jonnew/impedance/app/impedance-specification.markdown

Here i attempt to specify the functionality of the the impedance test/electrode plating application

Basic usage workflow

1. Enter global parameters
  * SPI port
2. Calibrate hardware
  1. Find the SPI cable delay. 
3. Calibrate the intan chip
4. Select a channel
  1. Select an impedance test frequency
  2. Select an impedance test amplitude
  3. Configute the impedance settings
  4. Measure impedancei
    1. Select series capacitance to generate current	
    2. Configure the impedance test settings
    3. Test impedance
    4. If not all capacitances have been checked, jump to (1) 
  5. Determine optimal impedance value
  6. Plate
    1. If at desired impedance then plate.
  7. Jump to (3)
