jonnew/impedance/impedance-pcb-intan/RHD2000_plating_board_assembly_guide.pptx

FR-4, 0.062” thick, gold immersion finish
Through-hole components and SMDs (no smaller than 0603) on top side only
(see BOM for details)

RHD2000 Plating Board

4.65”

0.125” holes in all four corners

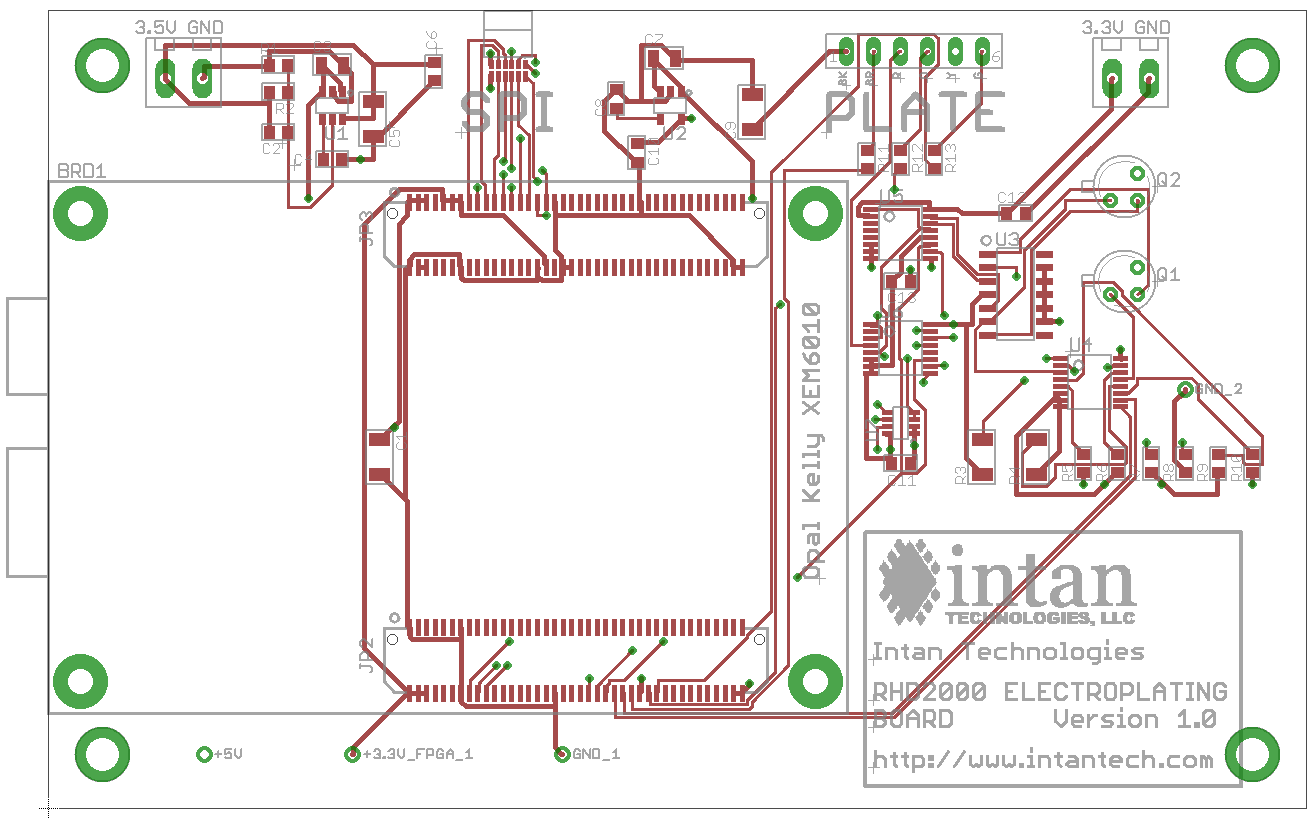
[picture p1: figure]

actual size

2.95”

## Slide 2

SMD Components (36 total)

Omnetics A79623

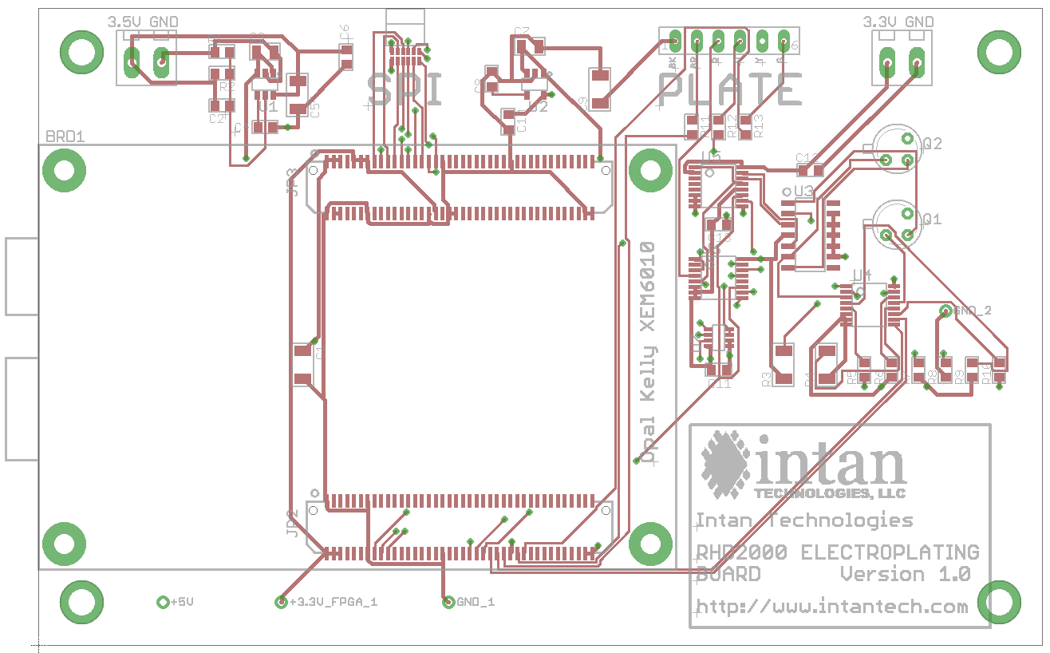
[picture p2: figure]

56.0 kΩ (1%)

30.1 kΩ (1%)

TPS79301

1 μF

22 μF

100 nF

10 nF

100 nF

1 μF

22 μF

15 pF

10 nF

Samtec BTE-040-01

TPS79333

100 Ω

100 nF

74HC4053

100 nF

OPA4170

22 μF

74HC4053

AD5662

74HC4052

100 nF

100 MΩ (1%)

100 MΩ (1%)

10.0 MΩ (1%)

10.0 MΩ (1%)

1.00 MΩ (1%)

1.00 MΩ (1%)

100 kΩ (1%)

100 kΩ (1%)

Samtec BTE-040-01

## Slide 3

Through-Hole Components (4 total)

Place terminal blocks with openings towards outside edge of board

ED1514

ED1514

2N3964

BC107
