jonnew/impedance/impedance-pcb/impedance_schematic.pdf

A

A

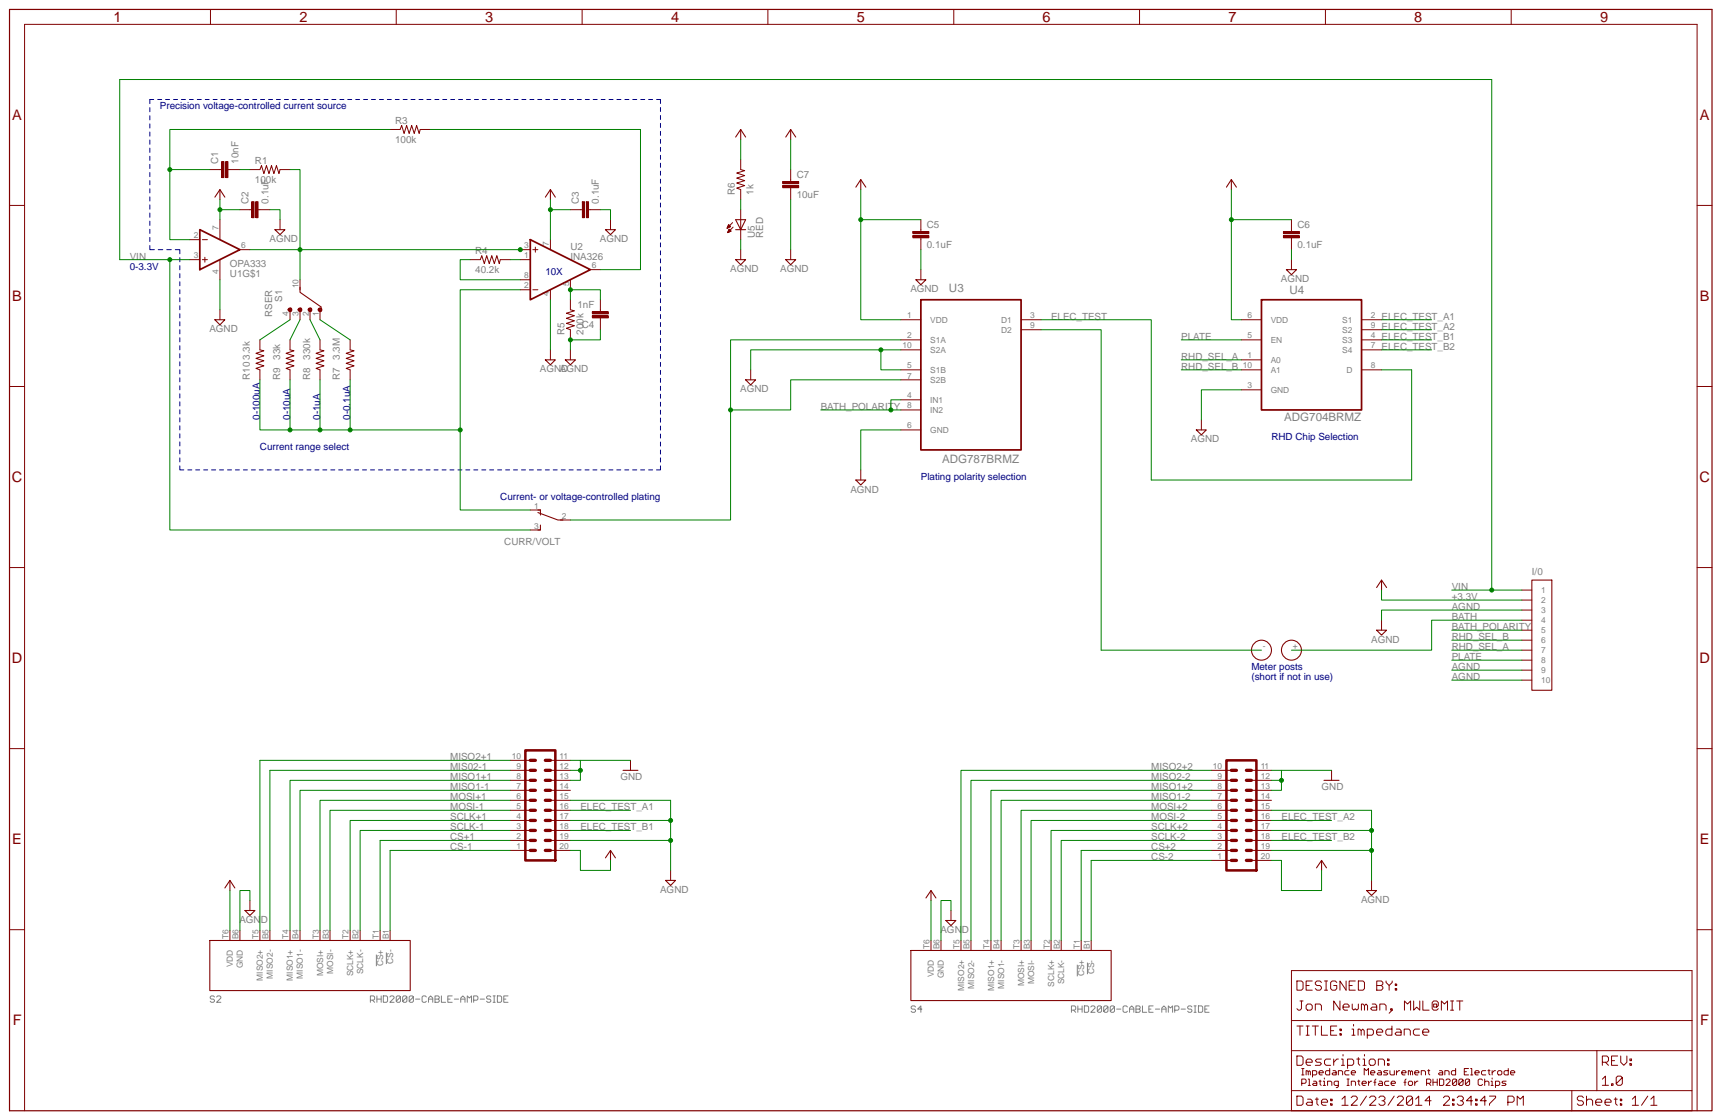
[picture p3: page 1]

Precision voltage-controlled current source

Current- or voltage-controlled plating

Meter posts
(short if not in use)
