jonnew/impedance/impedance-pcb-intan/RHD2000_plating_board.brd

## EAGLE design impedance-pcb-intan/RHD2000_plating_board.brd (2016-06-11)

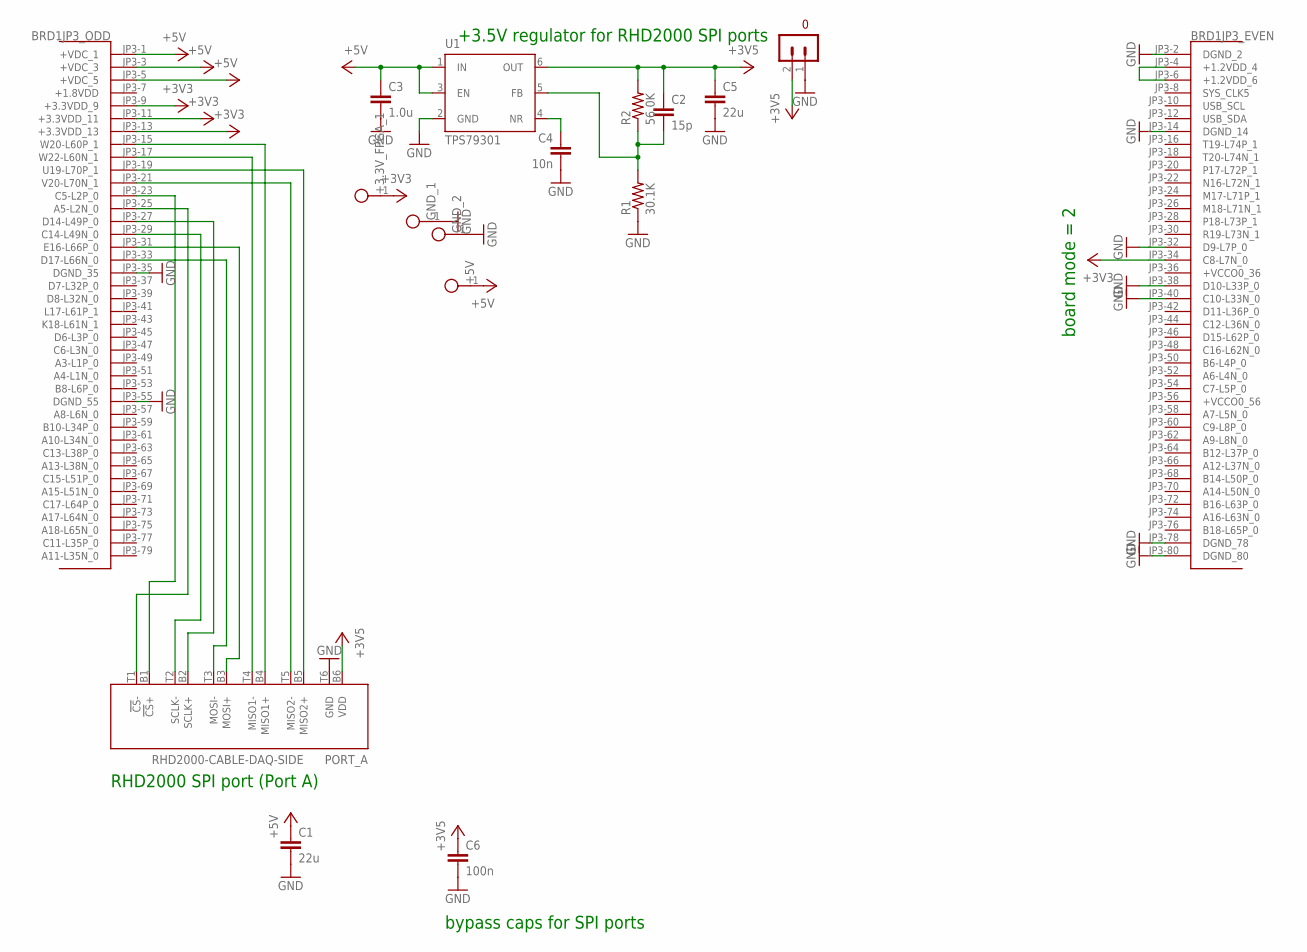
[picture p4: schematic RHD2000_plating_board.sch, sheet 1]

Parts:
+3.3V_FPGA_1, +5V: TESTPOINT
BRD1: OPALKELLY_XEM6010
C1, C5: 22u; 1206
C2: 15p; 0603
C3: 1.0u; 0805
C4: 10n; 0603
C6: 100n; 0603
GND_1, GND_2: TESTPOINT
PORT_A: RHD2000-CABLE-DAQ-SIDE; OMNETICS_PZN-12-AA
R1: 30.1K; 0603
R2: 56.0K; 0603
S2: TERMINAL_BLOCK_2-3.5MM-3.5V; TERMINAL_BLOCK_3.5MM_2_3.5V
U1: TPS79301; SOT-23-6

Connections:
+1.8VDD: BRD1.JP3-7 (+1.8VDD)
+3V3: +3.3V_FPGA_1.1, BRD1.JP3-9 (+3.3VDD_9), BRD1.JP3-11 (+3.3VDD_11), BRD1.JP3-13 (+3.3VDD_13), BRD1.JP3-34 (C8-L7N_0); also elsewhere on the board
+3V5: C2.1, C5.1, C6.1, PORT_A.B6 (VDD), R2.2, S2.2 (1), U1.6 (OUT)
+5V: +5V.1, BRD1.JP3-1 (+VDC_1), BRD1.JP3-3 (+VDC_3), BRD1.JP3-5 (+VDC_5), C1.1, C3.1, U1.1 (IN), U1.3 (EN); also elsewhere on the board
+VCCO0_36: BRD1.JP3-36 (+VCCO0_36)
+VCCO0_56: BRD1.JP3-56 (+VCCO0_56)
+VCCO1_35: BRD1.JP2-35 (+VCCO1_35)
+VCCO1_55: BRD1.JP2-55 (+VCCO1_55)
GND: BRD1.JP3-2 (DGND_2), BRD1.JP3-14 (DGND_14), BRD1.JP3-32 (D9-L7P_0), BRD1.JP3-35 (DGND_35), BRD1.JP3-38 (D10-L33P_0), BRD1.JP3-40 (C10-L33N_0), BRD1.JP3-55 (DGND_55), BRD1.JP3-78 (DGND_78), BRD1.JP3-80 (DGND_80), C1.2, C3.2, C4.2, C5.2, C6.2, GND_1.1, GND_2.1, PORT_A.T6 (GND), R1.1, S2.1 (0), U1.2 (GND); also elsewhere on the board
unnamed: BRD1.JP3-15 (W20-L60P_1), PORT_A.B4 (MISO1+)
unnamed: BRD1.JP3-17 (W22-L60N_1), PORT_A.T4 (MISO1-)
unnamed: BRD1.JP3-19 (U19-L70P_1), PORT_A.B5 (MISO2+)
unnamed: BRD1.JP3-21 (V20-L70N_1), PORT_A.T5 (MISO2-)
unnamed: BRD1.JP3-23 (C5-L2P_0), PORT_A.B1 (!CS!+)
unnamed: BRD1.JP3-25 (A5-L2N_0), PORT_A.T1 (!CS!-)
unnamed: BRD1.JP3-27 (D14-L49P_0), PORT_A.B2 (SCLK+)
unnamed: BRD1.JP3-29 (C14-L49N_0), PORT_A.T2 (SCLK-)
unnamed: BRD1.JP3-31 (E16-L66P_0), PORT_A.B3 (MOSI+)
unnamed: BRD1.JP3-33 (D17-L66N_0), PORT_A.T3 (MOSI-)
unnamed: C4.1, U1.4 (NR)
unnamed: C2.2, R1.2, R2.1, U1.5 (FB)
unnamed: BRD1.JP3-4 (+1.2VDD_4), BRD1.JP3-6 (+1.2VDD_6)

Notes on the sheet:
+3.5V regulator for RHD2000 SPI ports
RHD2000 SPI port (Port A)
board mode = 2
bypass caps for SPI ports

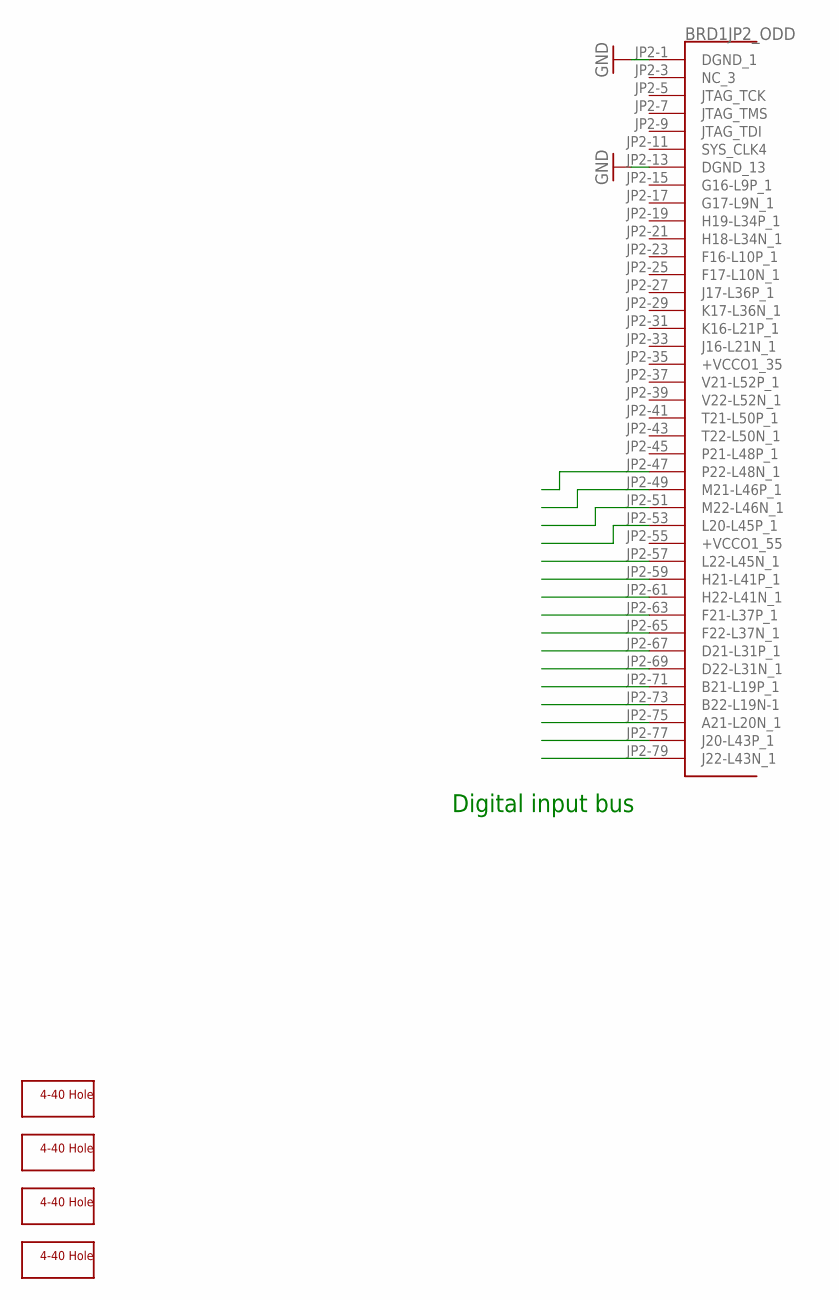
[picture p5: schematic RHD2000_plating_board.sch, sheet 2]

Parts:
BRD1: OPALKELLY_XEM6010
H1, H2, H3, H4: SCREW_HOLE_4-40

Connections:
+1.8VDD: BRD1.JP3-7 (+1.8VDD)
+VCCO0_36: BRD1.JP3-36 (+VCCO0_36)
+VCCO0_56: BRD1.JP3-56 (+VCCO0_56)
+VCCO1_35: BRD1.JP2-35 (+VCCO1_35)
+VCCO1_55: BRD1.JP2-55 (+VCCO1_55)
GND: BRD1.JP2-1 (DGND_1), BRD1.JP2-13 (DGND_13); also elsewhere on the board

Notes on the sheet:
Digital input bus

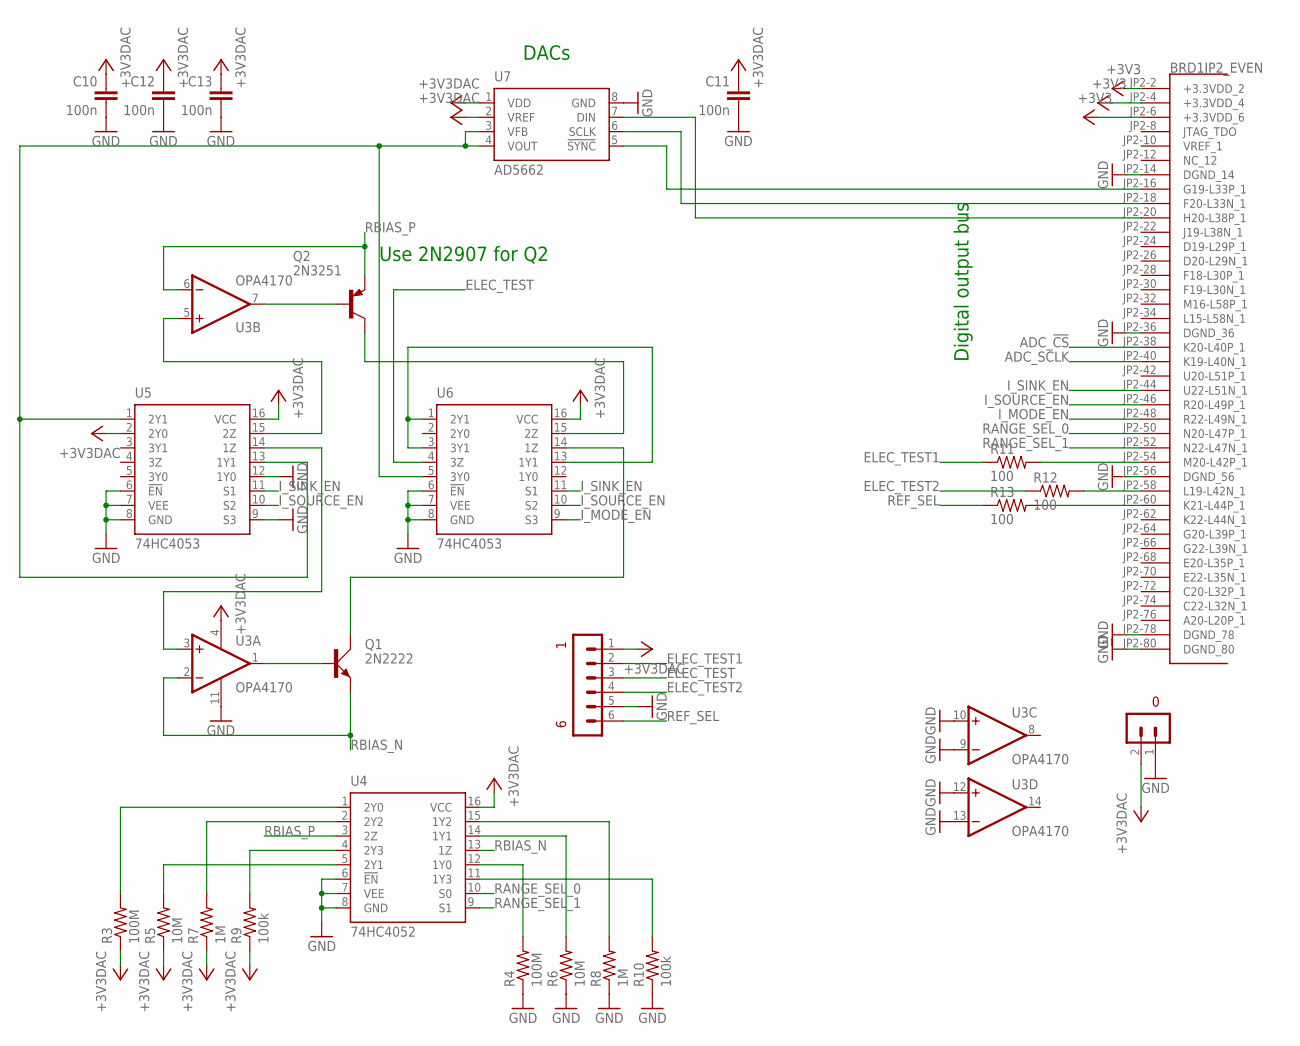
[picture p6: schematic RHD2000_plating_board.sch, sheet 3]

Parts:
BRD1: OPALKELLY_XEM6010
C10, C11, C12, C13: 100n; 0603
Q1: 2N2222; TO18A
Q2: 2N3251; TO18
R3, R4: 100M; 1206
R5, R6: 10M; 0603
R7, R8: 1M; 0603
R9, R10: 100k; 0603
R11, R12, R13: 100; 0603
S1: TERMINAL_BLOCK_2-3.5MM-3.3V; TERMINAL_BLOCK_3.5MM_2_3.3V
S3: WIRES-6
U3: OPA4170; SOIC-14
U4: 74HC4052; TSSOP-16
U5, U6: 74HC4053; TSSOP-16
U7: AD5662; SOT-23-RJ-8

Connections:
+1.8VDD: BRD1.JP3-7 (+1.8VDD)
+3V3: BRD1.JP2-2 (+3.3VDD_2), BRD1.JP2-4 (+3.3VDD_4), BRD1.JP2-6 (+3.3VDD_6); also elsewhere on the board
+3V3DAC: C10.1, C11.1, C12.1, C13.1, R3.1, R5.1, R7.1, R9.1, S1.2 (1), S3.1, U3.4 (V+), U4.16 (VCC), U5.2 (2Y0), U5.16 (VCC), U6.16 (VCC), U7.1 (VDD), U7.2 (VREF); also elsewhere on the board
+VCCO0_36: BRD1.JP3-36 (+VCCO0_36)
+VCCO0_56: BRD1.JP3-56 (+VCCO0_56)
+VCCO1_35: BRD1.JP2-35 (+VCCO1_35)
+VCCO1_55: BRD1.JP2-55 (+VCCO1_55)
ADC_!CS!: BRD1.JP2-38 (K20-L40P_1)
ADC_SCLK: BRD1.JP2-40 (K19-L40N_1)
ELEC_TEST: S3.3, U6.4 (3Z)
ELEC_TEST1: R11.1, S3.2
ELEC_TEST2: R12.1, S3.4
GND: BRD1.JP2-14 (DGND_14), BRD1.JP2-36 (DGND_36), BRD1.JP2-56 (DGND_56), BRD1.JP2-78 (DGND_78), BRD1.JP2-80 (DGND_80), C10.2, C11.2, C12.2, C13.2, R4.1, R6.1, R8.1, R10.1, S1.1 (0), S3.5, U3.9 (-IN), U3.10 (+IN), U3.11 (V-), U3.12 (+IN), U3.13 (-IN), U4.6 (!EN!), U4.7 (VEE), U4.8 (GND), U5.6 (!EN!), U5.7 (VEE), U5.8 (GND), U5.9 (S3), U5.12 (1Y0), U6.6 (!EN!), U6.7 (VEE), U6.8 (GND), U7.8 (GND); also elsewhere on the board
I_MODE_EN: BRD1.JP2-48 (R22-L49N_1), U6.9 (S3)
I_SINK_EN: BRD1.JP2-44 (U22-L51N_1), U5.11 (S1), U6.11 (S1)
I_SOURCE_EN: BRD1.JP2-46 (R20-L49P_1), U5.10 (S2), U6.10 (S2)
unnamed: Q1.B, U3.1 (OUT)
unnamed: U5.1 (2Y1), U5.13 (1Y1), U6.5 (3Y0), U7.3 (VFB), U7.4 (VOUT)
unnamed: U3.3 (+IN), U5.14 (1Z)
unnamed: Q1.C, U6.14 (1Z)
unnamed: U3.5 (+IN), U5.15 (2Z)
unnamed: Q2.2 (B), U3.7 (OUT)
unnamed: Q2.3 (C), U6.15 (2Z)
unnamed: BRD1.JP2-54 (M20-L42P_1), R11.2
unnamed: BRD1.JP2-58 (L19-L42N_1), R12.2
unnamed: R9.2, U4.4 (2Y3)
unnamed: R7.2, U4.2 (2Y2)
unnamed: R5.2, U4.5 (2Y1)
unnamed: R3.2, U4.1 (2Y0)
unnamed: R4.2, U4.12 (1Y0)
unnamed: R6.2, U4.14 (1Y1)
unnamed: R8.2, U4.15 (1Y2)
unnamed: R10.2, U4.11 (1Y3)
unnamed: U6.1 (2Y1), U6.3 (3Y1), U6.13 (1Y1)
unnamed: BRD1.JP2-60 (K21-L44P_1), R13.2
unnamed: BRD1.JP2-16 (G19-L33P_1), U7.5 (!SYNC!)
unnamed: BRD1.JP2-18 (F20-L33N_1), U7.6 (SCLK)
unnamed: BRD1.JP2-20 (H20-L38P_1), U7.7 (DIN)
RANGE_SEL_0: BRD1.JP2-50 (N20-L47P_1), U4.10 (S0)
RANGE_SEL_1: BRD1.JP2-52 (N22-L47N_1), U4.9 (S1)
RBIAS_N: Q1.E, U3.2 (-IN), U4.13 (1Z)
RBIAS_P: Q2.1 (E), U3.6 (-IN), U4.3 (2Z)
REF_SEL: R13.1, S3.6

Notes on the sheet:
DACs
Digital output bus
Use 2N2907 for Q2

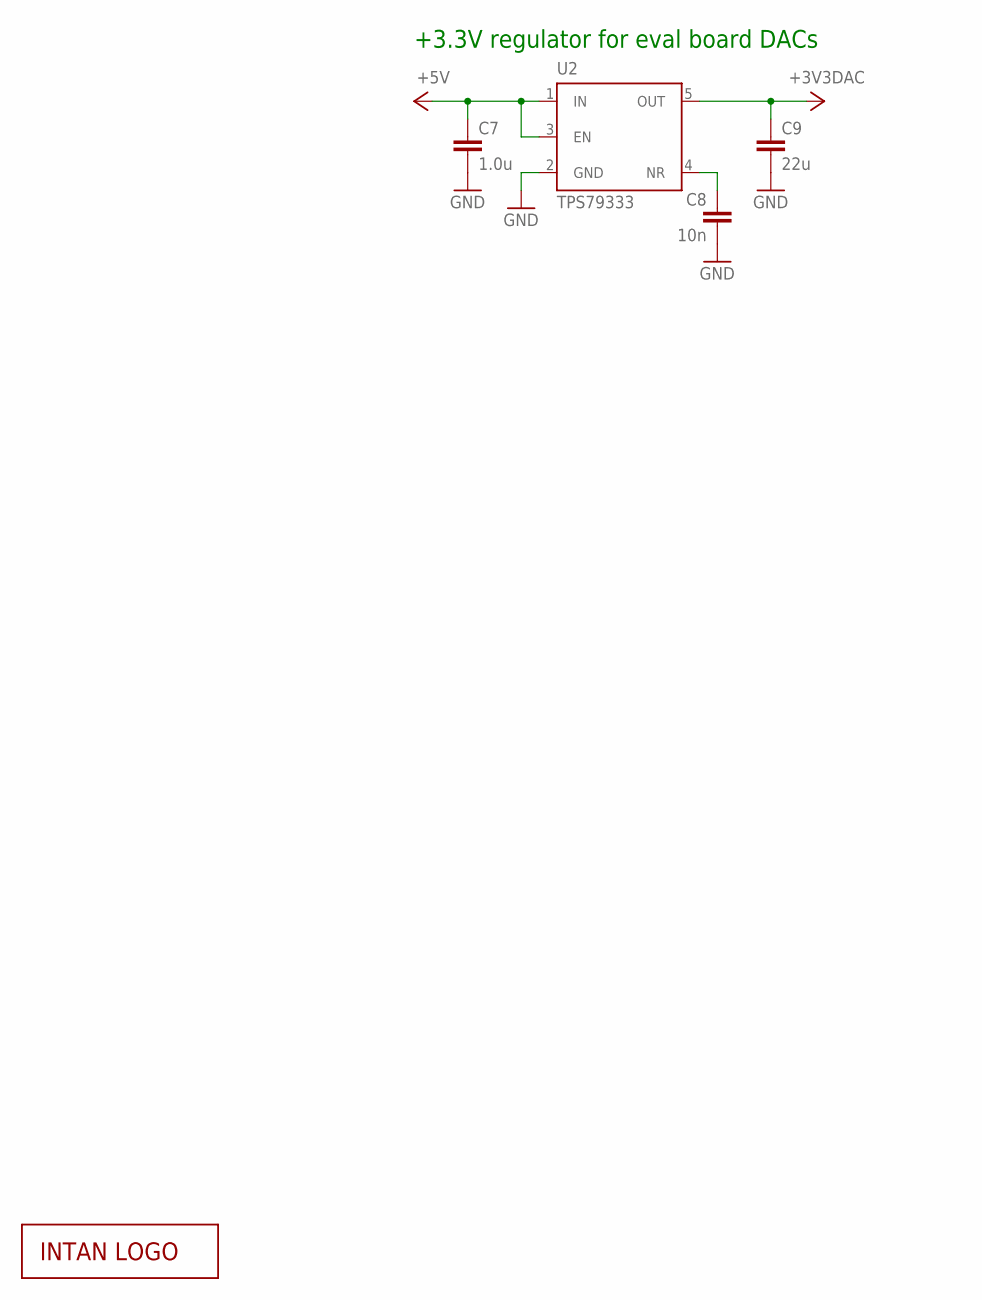
[picture p7: schematic RHD2000_plating_board.sch, sheet 4]

Parts:
C7: 1.0u; 0805
C8: 10n; 0603
C9: 22u; 1206
LOGO1: INTAN_LOGO
U2: TPS79333; SOT-23-5

Connections:
+3V3DAC: C9.1, U2.5 (OUT); also elsewhere on the board
+5V: C7.1, U2.1 (IN), U2.3 (EN); also elsewhere on the board
GND: C7.2, C8.2, C9.2, U2.2 (GND); also elsewhere on the board
unnamed: C8.1, U2.4 (NR)

Notes on the sheet:
+3.3V regulator for eval board DACs

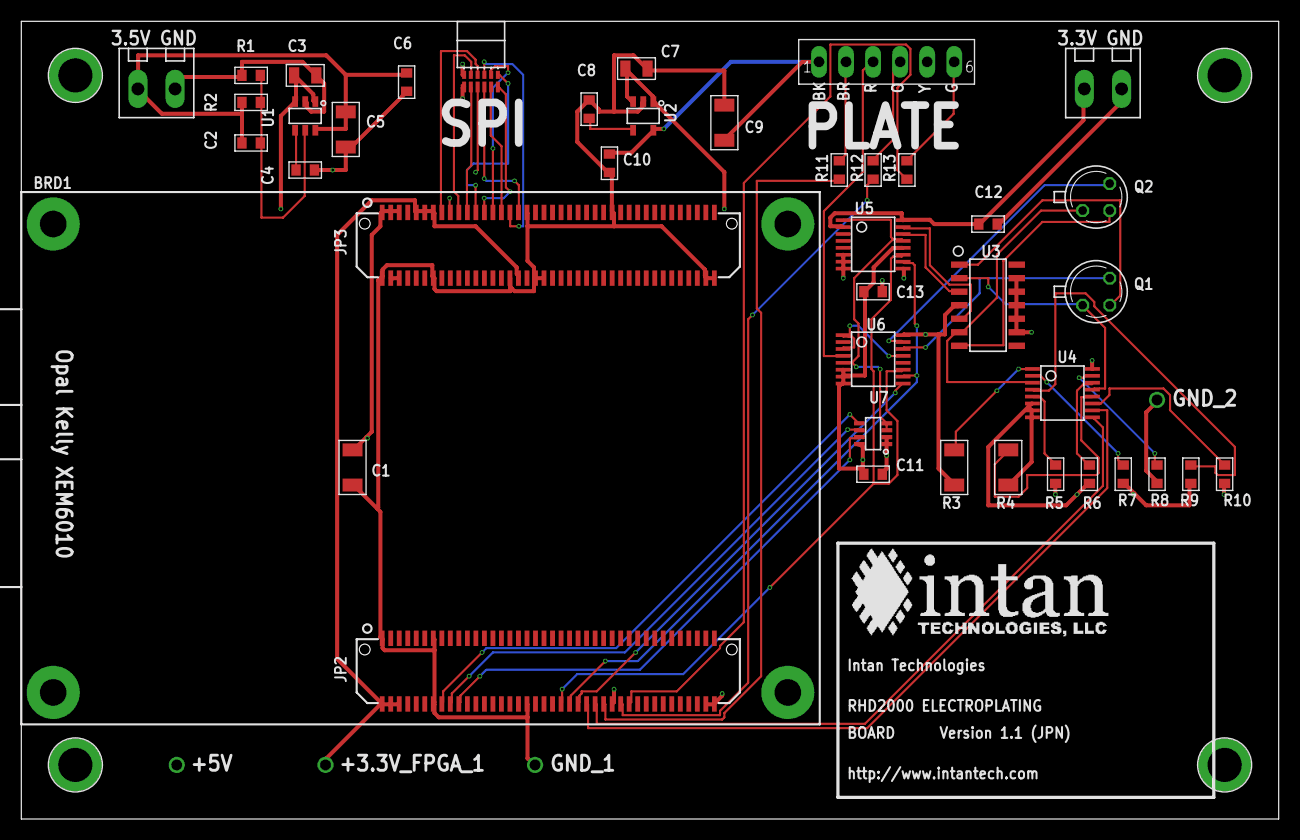
[picture p8: board RHD2000_plating_board.brd from above]

Board: 4 copper layers, 118.1 x 74.9 mm, 49 parts (0 on the bottom side), 52 nets.
