jonnew/impedance/impedance-pcb/impedance.brd

## EAGLE design impedance-pcb/impedance.brd (2014-12-23)

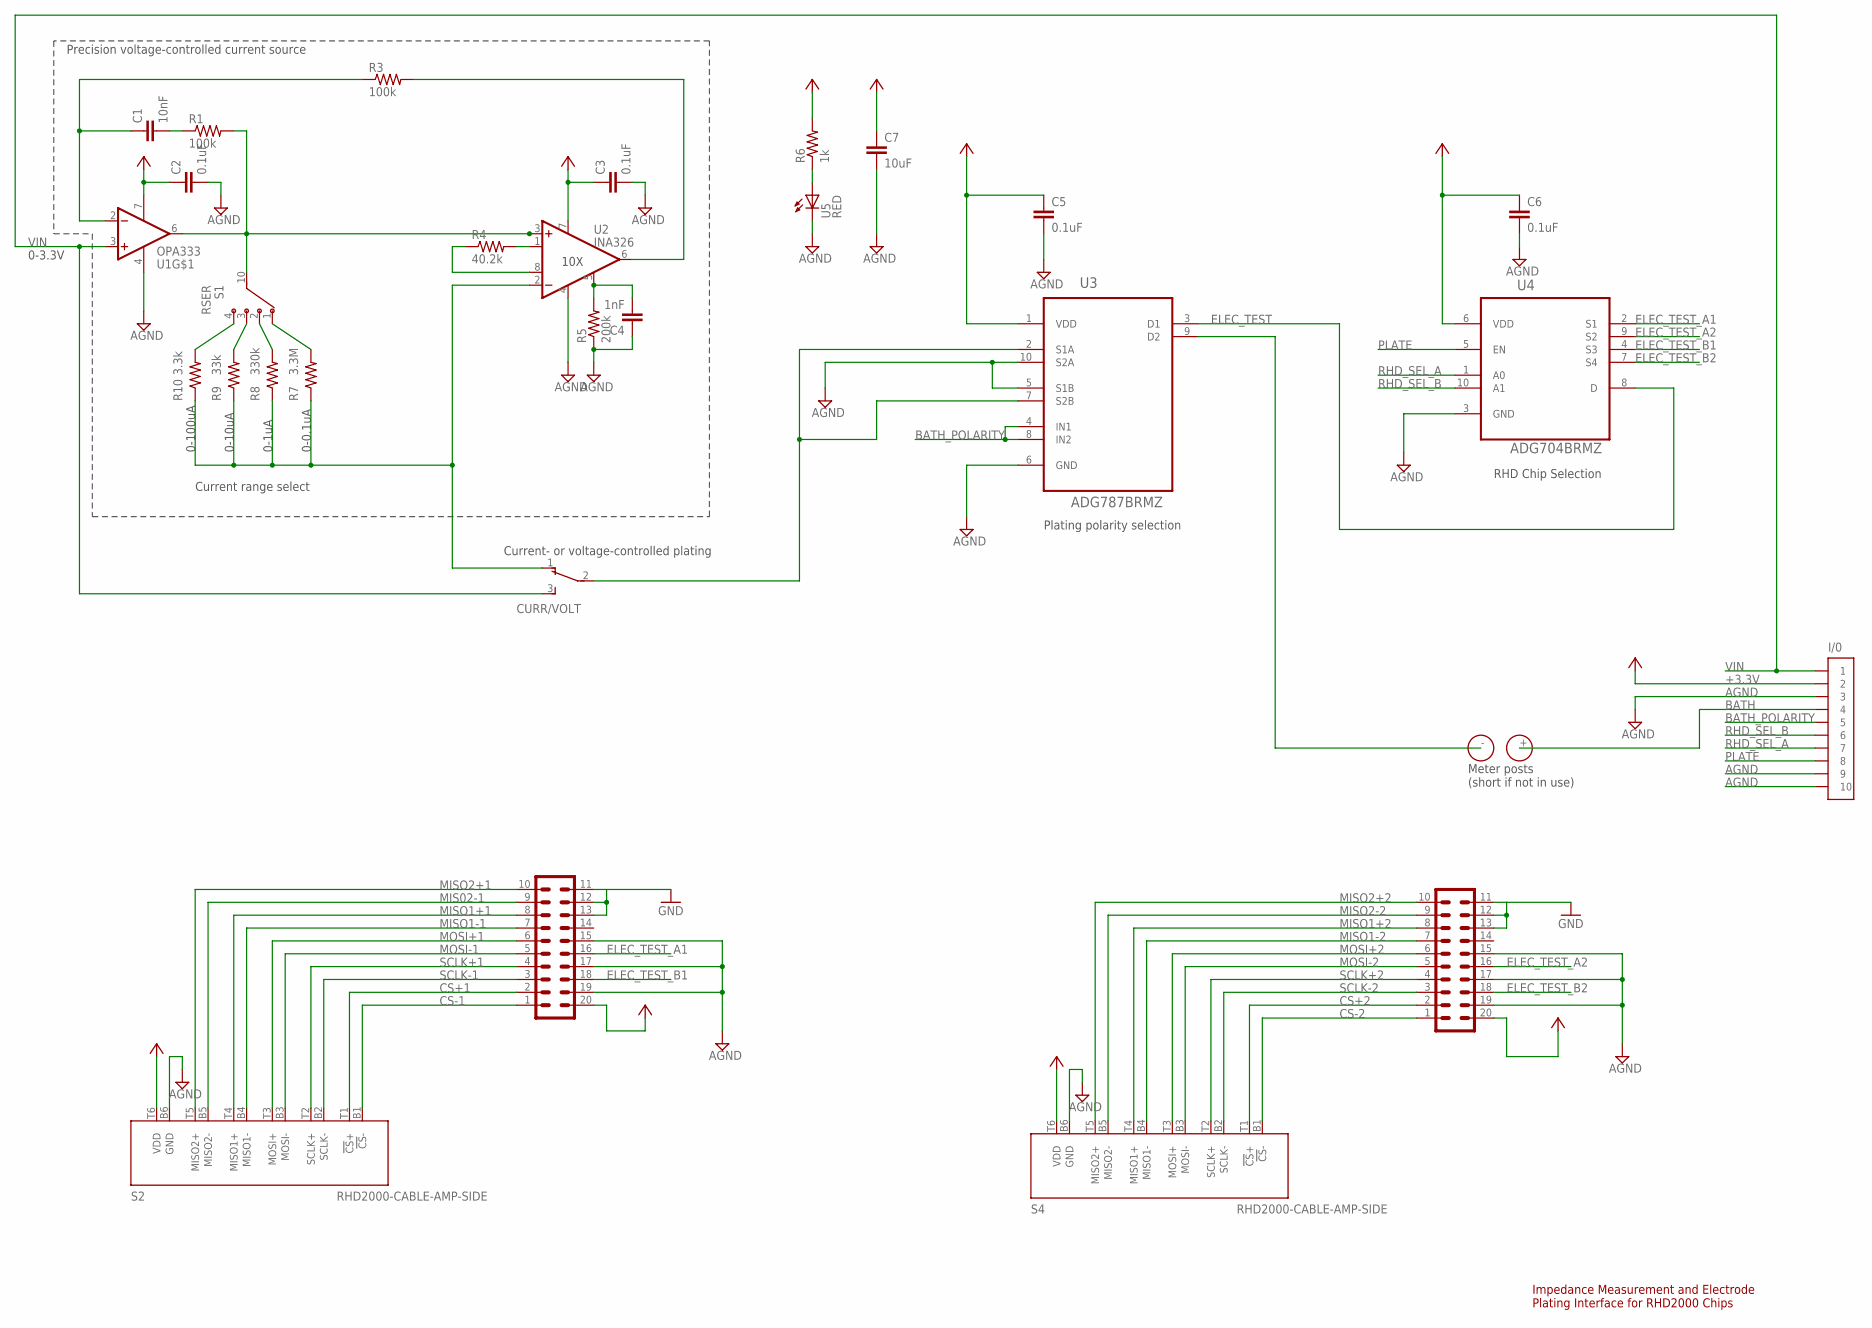
[picture p9: schematic impedance.sch]

Parts:
C1: 10nF; 0805
C2, C3, C5, C6: 0.1uF; 0805
C4: 1nF; 0805
C7: 10uF; 1206
CURR/VOLT: SPDT_PCM12; PCM12
HS1, HS2: JMD20-V
I/0: SCREW10_0.1-THRU; SCREW10
R1, R3: 100k; 0805
R4: 40.2k; 0805
R5: 200k; 0805
R6: 1k; 0805
R7: 3.3M; 0805
R8: 330k; 0805
R9: 33k; 0805
R10: 3.3k; 0805
S1: RSER; R-SWITCH
S2, S4: RHD2000-CABLE-AMP-SIDE; OMNETICS_PZN-12-AA
U1: OPA333; SOIC127P600X175-8N
U2: INA326; SOP65P490X110-8N
U3: ADG787BRMZ; SOP50P490X110-10N
U4: ADG704BRMZ; SOP50P490X110-10N
U5: RED; CHIP-LED0603
U$2: DUAL-POST_BANANA; BANANA-BINDING-POST

Connections:
+3.3V: C2.1, C3.1, C5.1, C6.1, C7.1, HS1.20, HS2.20, I/0.P$2 (2), R6.2, S2.T6 (VDD), S4.T6 (VDD), U1.7 (V+), U3.1 (VDD), U4.6 (VDD)
AGND: C2.2, C3.2, C4.1, C5.2, C6.2, C7.2, HS1.15, HS1.17, HS1.19, HS2.15, HS2.17, HS2.19, I/0.P$3 (3), I/0.P$9 (9), I/0.P$10 (10), R5.1, S2.B6 (GND), S4.B6 (GND), U1.4 (V-), U2.4 (V-), U3.5 (S1B), U3.6 (GND), U3.10 (S2A), U4.3 (GND), U5.C
BATH: I/0.P$4 (4), U$2.+ (1)
BATH_POLARITY: I/0.P$5 (5), U3.4 (IN1), U3.8 (IN2)
CS+1: HS1.2, S2.T1 (!CS!+)
CS+2: HS2.2, S4.T1 (!CS!+)
CS-1: HS1.1, S2.B1 (!CS!-)
CS-2: HS2.1, S4.B1 (!CS!-)
ELEC_TEST: U3.3 (D1), U4.8 (D)
ELEC_TEST_A1: HS1.16, U4.2 (S1)
ELEC_TEST_A2: HS2.16, U4.9 (S2)
ELEC_TEST_B1: HS1.18, U4.4 (S3)
ELEC_TEST_B2: HS2.18, U4.7 (S4)
GND: HS1.11, HS1.12, HS1.13, HS2.11, HS2.12, HS2.13
IOUT: CURR/VOLT.2, U3.2 (S1A), U3.7 (S2B)
MIS02-1: HS1.9, S2.B5 (MISO2-)
MISO1+1: HS1.8, S2.T4 (MISO1+)
MISO1+2: HS2.8, S4.T4 (MISO1+)
MISO1-1: HS1.7, S2.B4 (MISO1-)
MISO1-2: HS2.7, S4.B4 (MISO1-)
MISO2+1: HS1.10, S2.T5 (MISO2+)
MISO2+2: HS2.10, S4.T5 (MISO2+)
MISO2-2: HS2.9, S4.B5 (MISO2-)
MOSI+1: HS1.6, S2.T3 (MOSI+)
MOSI+2: HS2.6, S4.T3 (MOSI+)
MOSI-1: HS1.5, S2.B3 (MOSI-)
MOSI-2: HS2.5, S4.B3 (MOSI-)
unnamed: R1.2, S1.10 (COM), U1.6 (OUT), U2.3 (+IN)
unnamed: R4.2, U2.1 (R1_A)
unnamed: R4.1, U2.8 (R1_B)
unnamed: C1.2, R1.1
unnamed: C1.1, R3.1, U1.2 (-IN)
unnamed: R3.2, U2.6 (OUT)
unnamed: C4.2, R5.2, U2.5 (R2)
unnamed: R6.1, U5.A
unnamed: CURR/VOLT.1, R7.1, R8.1, R9.1, R10.1, U2.2 (-IN)
unnamed: R10.2, S1.4
unnamed: R9.2, S1.3
unnamed: R8.2, S1.2
unnamed: R7.2, S1.1
unnamed: U3.9 (D2), U$2.- (2)
PLATE: I/0.P$6 (6), U4.5 (EN)
RHD_SEL_A: I/0.P$7 (7), U4.1 (A0)
RHD_SEL_B: I/0.P$8 (8), U4.10 (A1)
SCLK+1: HS1.4, S2.T2 (SCLK+)
SCLK+2: HS2.4, S4.T2 (SCLK+)
SCLK-1: HS1.3, S2.B2 (SCLK-)
SCLK-2: HS2.3, S4.B2 (SCLK-)
VIN: CURR/VOLT.3, I/0.P$1 (1), U1.3 (+IN)

Notes on the sheet:
0-0.1uA
0-1uA
0-10uA
0-100uA
Current range select
0-3.3V
10X
Meter posts (short if not in use)
Current- or voltage-controlled plating
Impedance Measurement and Electrode Plating Interface for RHD2000 Chips
Plating polarity selection
RHD Chip Selection
Precision voltage-controlled current source

Board: 2 copper layers, 29 parts (0 on the bottom side), 49 nets, no tracks yet.
