jonnew/impedance/app/qtinclude.h

#ifndef QTINCLUDE_H
#define QTINCLUDE_H

// Space for all QT-specific libraries
// These might be removed if this is ever ported to OE so, I want to keep these
// together

#include <QVector>
#include <QString>
#include <QDataStream>
#include <QTime>
#include <qmath.h>
#include <QVector>
//#include <QThread>
#include <iostream>
#include <QQueue>
#include <QTextStream>



#endif // QTINCLUDE_H
