jonnew/impedance/(commit log)

2014-11-08 Started the pcb.
    [impedance.brd, impedance.sch]
2014-11-08 Created plating/impedance testing circuit. Need to get parts to prototype it.
    [impedance.brd, impedance.sch]
2014-12-23 Updated the impedance test interface schematic based on testing.
    [impedance.brd, impedance.sch]
2015-01-02 Started converting the impedance testing code to a library, but I have not worked the kinks out yet.
    [globalconstants.h, main.cpp, okFrontPanelDLL.cpp, platecontrol.cpp, platecontrol.h, qtinclude.h, randomnumber.cpp, randomnumber.h]
2015-01-08 Added an interactive mode to the application, data saving capabilities, and other mods. The app is broken right now.
    [main.cpp, platecontrol.cpp, platecontrol.h, qtinclude.h, rhd2000evalboardimpedancetester.h, rhd2000evalboardimpedancetester_global.h, rhd2000impedance.cpp, rhd2000impedance.h]
2015-01-09 Numerous bug fixes and improvements to UI. Log files can now be saved.
    [main.cpp, platecontrol.cpp, platecontrol.h, rhd2000impedance.cpp, rhd2000impedance.h]
2015-01-10 Numerous linux bug fixes, improvements to UI. Time to test again.
    [main.cpp, platecontrol.cpp, rhd2000impedance.cpp, rhd2000impedance.h]
2015-03-03 Added Intan's new board to the repo to see if I can just use that.
    [BOM_RHD2000_plating_board.xlsx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]
2015-07-29 Update to PCB design due to the screw header not fitting.
    - Made through holes slightly larger to accomindate 6-pin screw header.
    - Have to decide if I will puchase commerical software from Intan or
    revive my own application, which is very terrible at this point.
    [RHD2000_plating_board.brd, RHD2000_plating_board.sch]
2016-06-11 Fixed reversed resistor labels in 3.5V regulator circuit.
    [RHD2000_plating_board.brd]
