jonnew/impedance/(notices)

Notices in the files:
RHD2000EvalBoardImpedanceTester/signalchannel.cpp:
This program is free software: you can redistribute it and/or modify
it under the terms of the GNU Lesser General Public License as published
